jonaboecker/turingmaschine/assets/Treiber_Kalibrieren.jpg

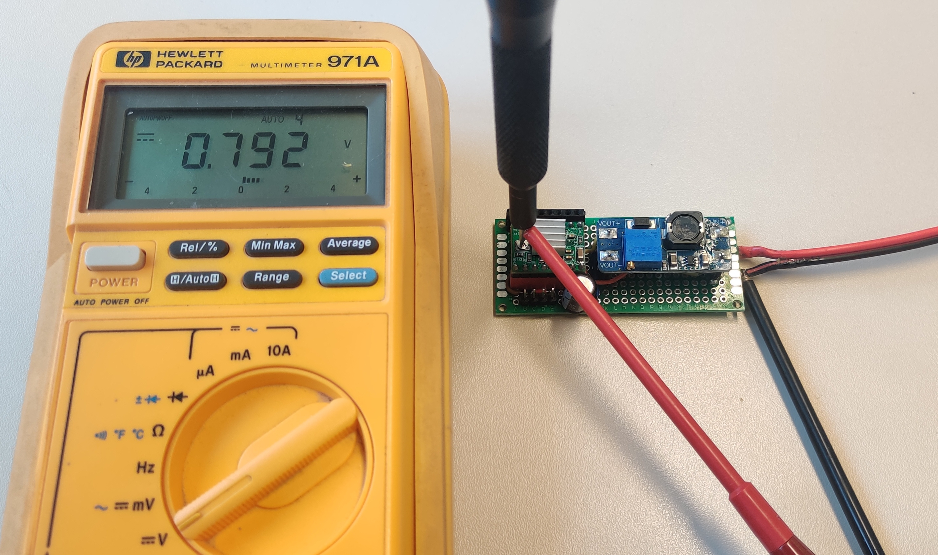
assets/Treiber_Kalibrieren.jpg
