jonaboecker/turingmaschine/assets/TCS3200_Pinout.png

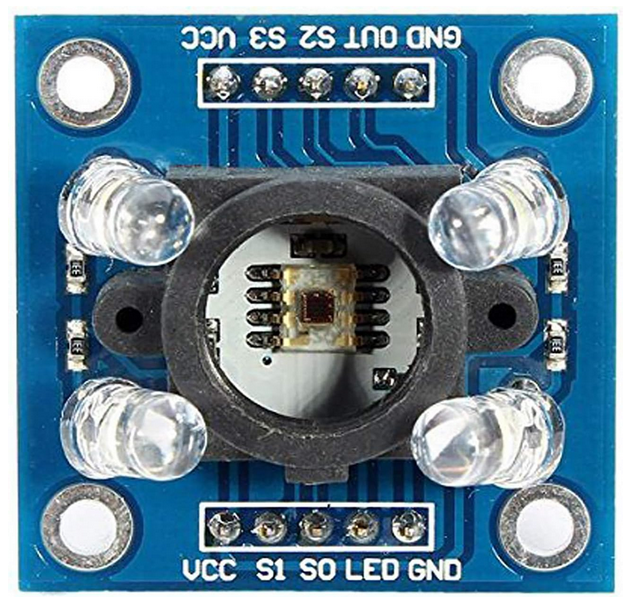
assets/TCS3200_Pinout.png
