jonaboecker/turingmaschine/arduino/assets/images/TM_Taster.jpg

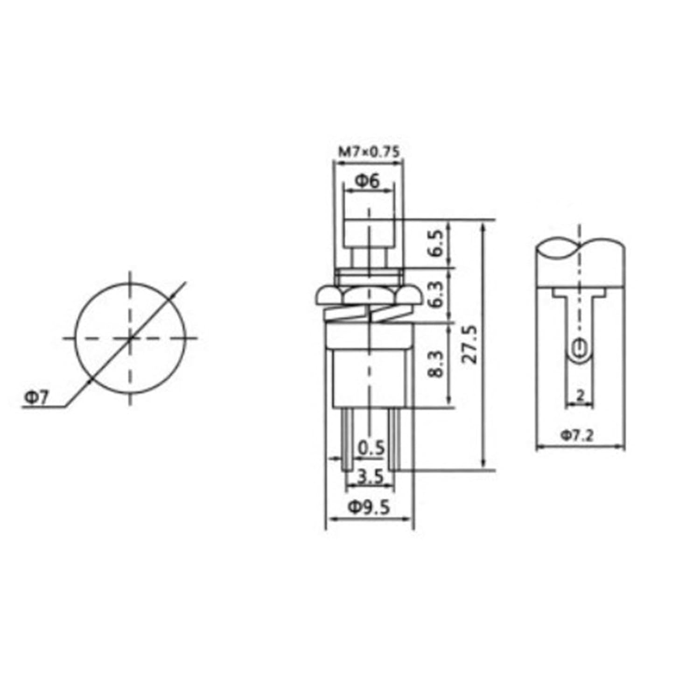
arduino/assets/images/TM_Taster.jpg
