jonaboecker/turingmaschine/arduino/assets/images/turingmachine_io_ribbon_prototype_breadBoard.png

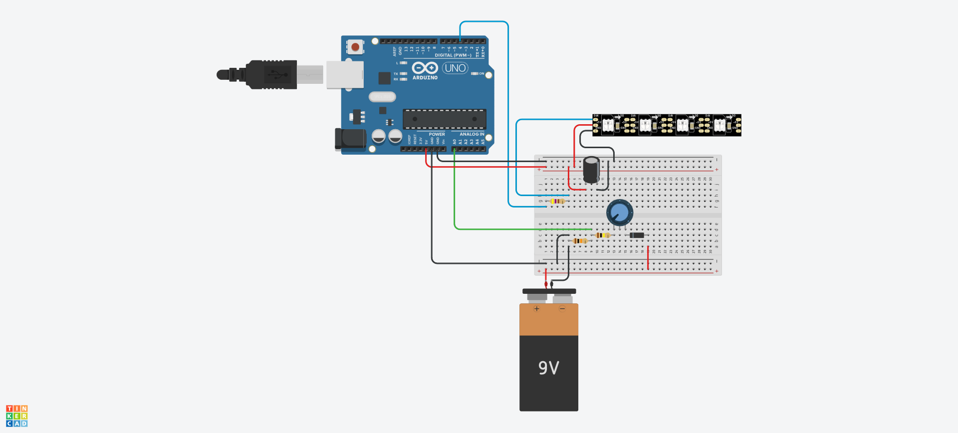
arduino/assets/images/turingmachine_io_ribbon_prototype_breadBoard.png
