jonaboecker/turingmaschine/arduino/assets/images/turingmachine_io_ribbon_prototype_circuitDiagram_pic.png

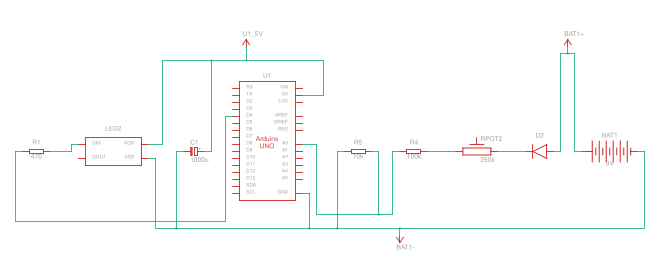
arduino/assets/images/turingmachine_io_ribbon_prototype_circuitDiagram_pic.png
