jonaboecker/turingmaschine/assets/17HE19-2004S_Steppermotor_Datasheet.png

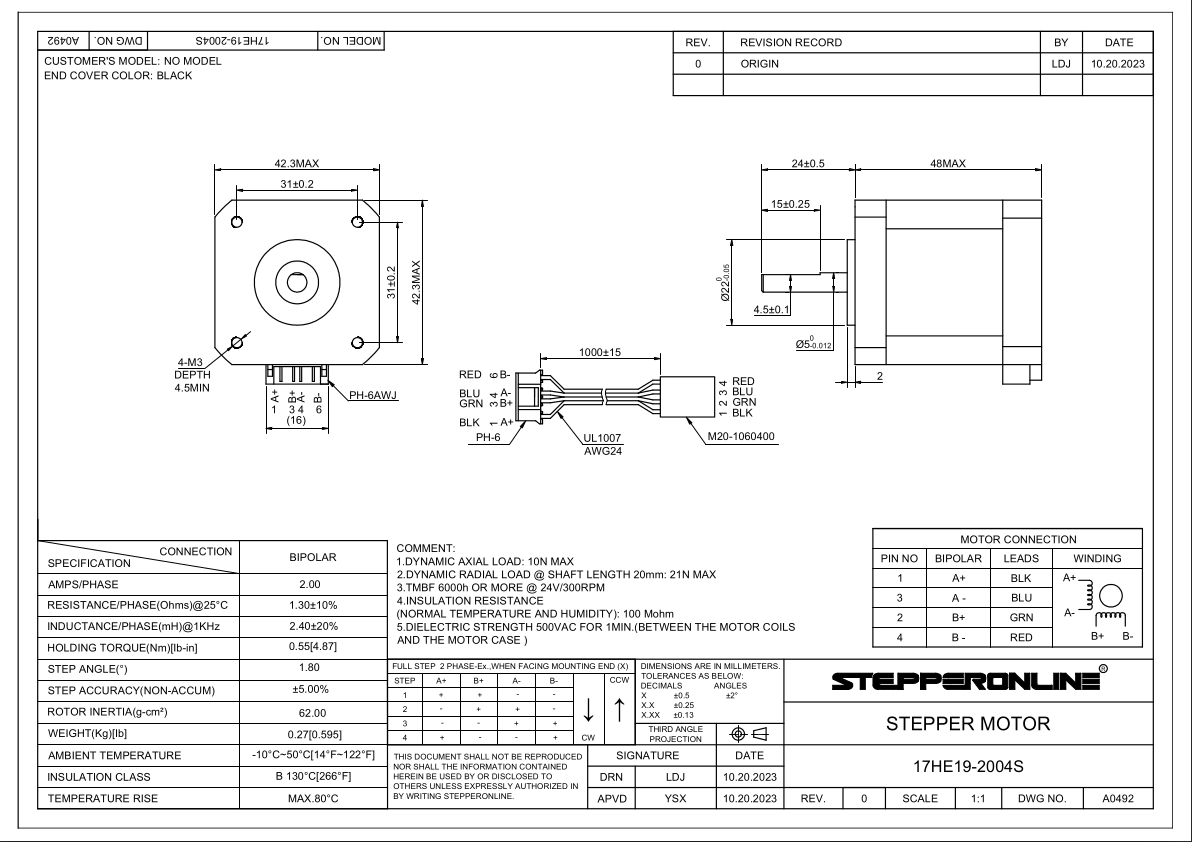
assets/17HE19-2004S_Steppermotor_Datasheet.png
