jonaboecker/turingmaschine/assets/A4988_Driver_Pinout.png

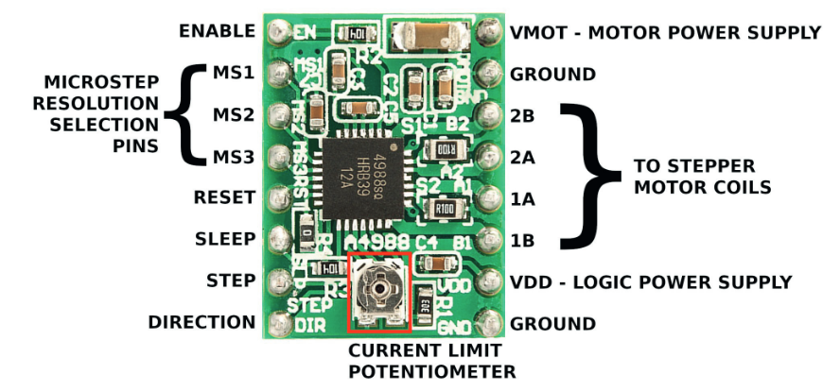
assets/A4988_Driver_Pinout.png
