jonaboecker/turingmaschine/assets/cabel_chain_output_cabel.png

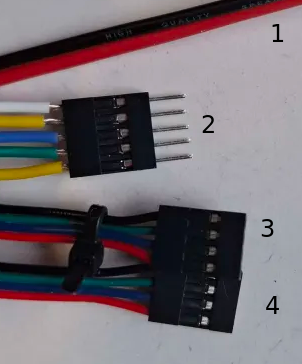
assets/cabel_chain_output_cabel.png
