jonaboecker/turingmaschine/assets/Display_Anschluss.png

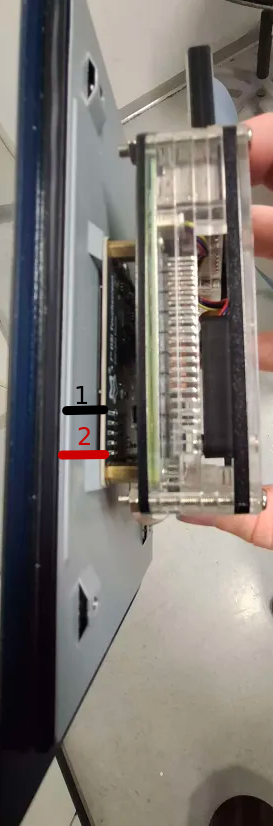
assets/Display_Anschluss.png
