jonaboecker/turingmaschine/assets/Lego_GearRack_w_Border_191mm.PNG

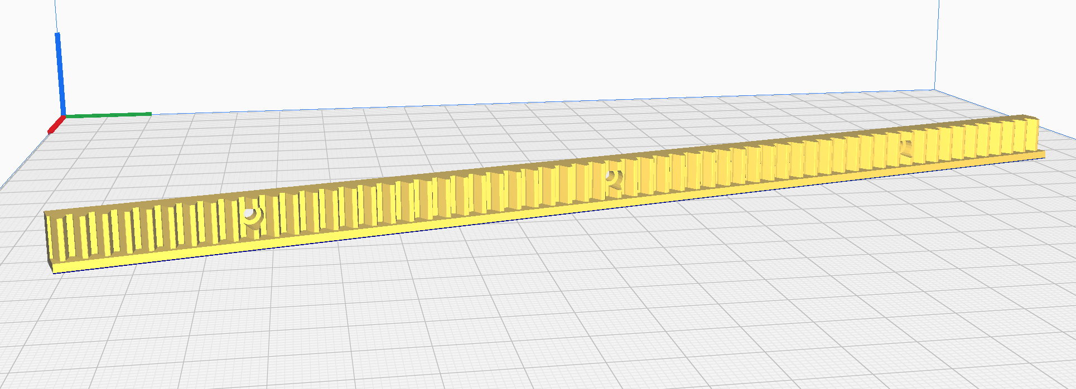
assets/Lego_GearRack_w_Border_191mm.PNG
