jonaboecker/turingmaschine/assets/Lichtschranke.png

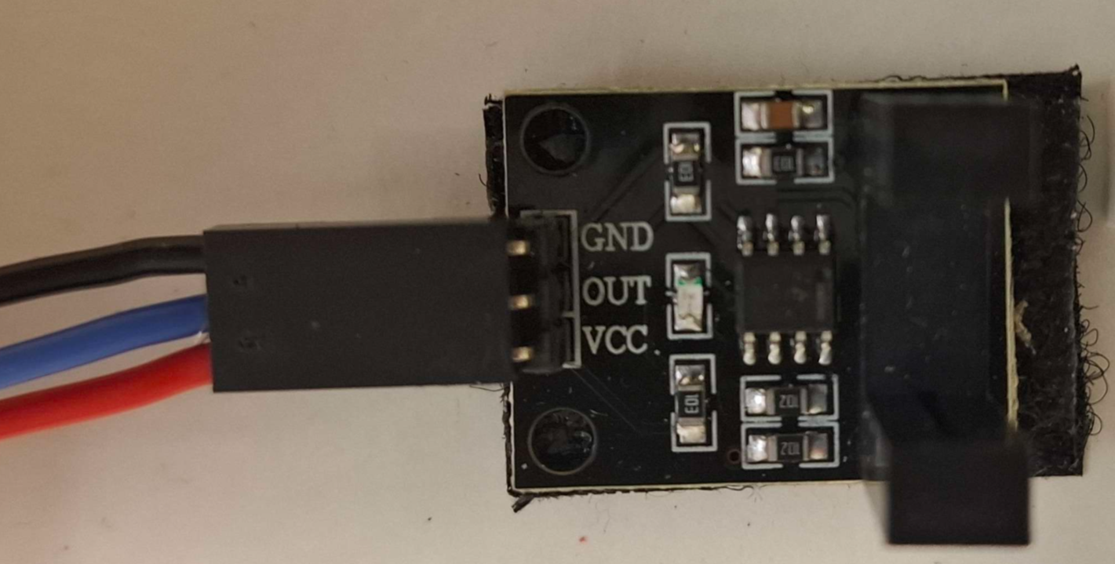
assets/Lichtschranke.png
