jonaboecker/turingmaschine/assets/LM393 Lightsensor.png

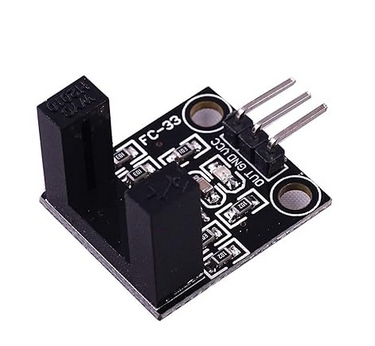
assets/LM393 Lightsensor.png
