jonaboecker/turingmaschine/assets/Netzteil_5V_Ground.png

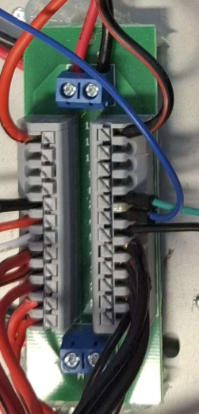
assets/Netzteil_5V_Ground.png
