jonaboecker/turingmaschine/assets/RGB_LED_Voltage_supply_module.jpg

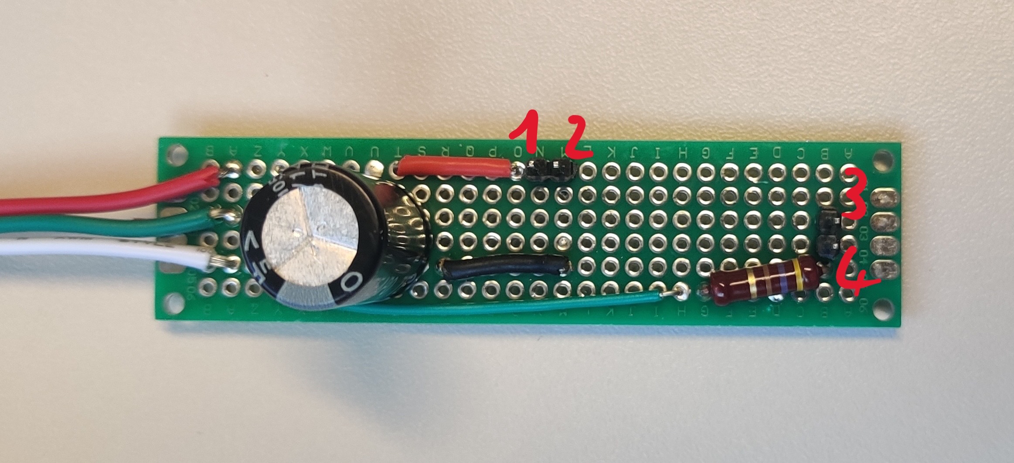
assets/RGB_LED_Voltage_supply_module.jpg
