jonaboecker/turingmaschine/assets/roboter_VGA.png

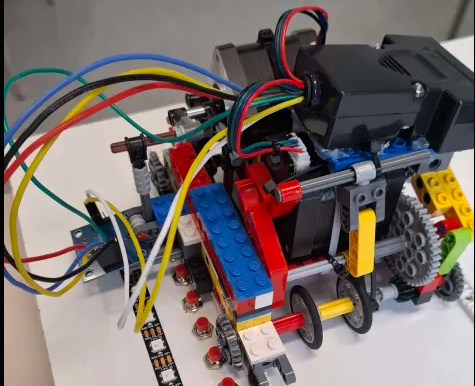
assets/roboter_VGA.png
