jonaboecker/turingmaschine/assets/roboter_VGA_cable_chain.png

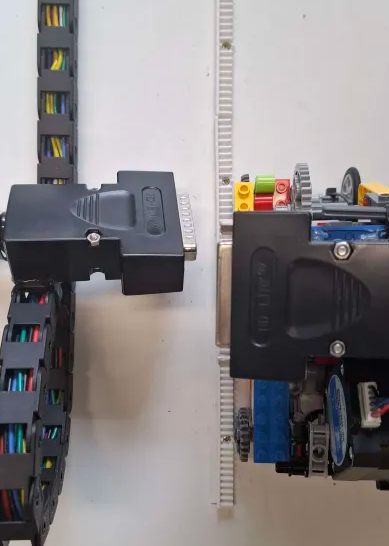
assets/roboter_VGA_cable_chain.png
