jonaboecker/turingmaschine/assets/Schaltplan_Steppermotor_Modul.png

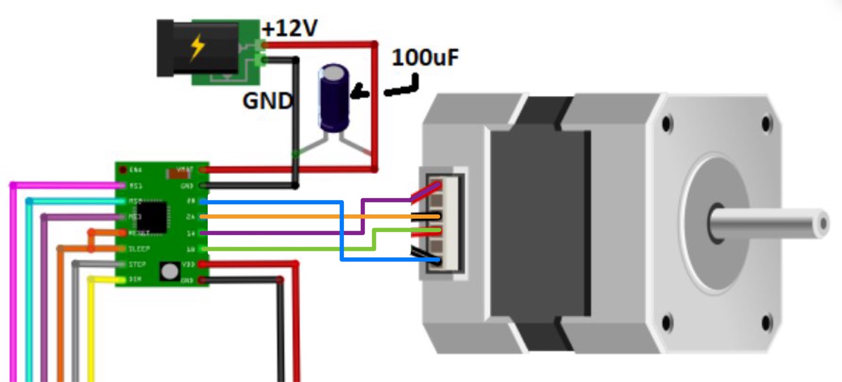
assets/Schaltplan_Steppermotor_Modul.png
