jonaboecker/turingmaschine/assets/Spannungswandler_bedienung.png

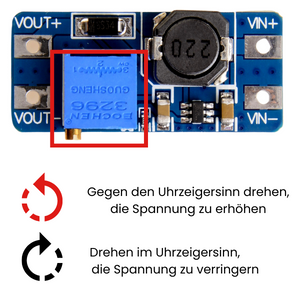
assets/Spannungswandler_bedienung.png
