jonaboecker/turingmaschine/assets/Steppermotor_controlling_and_voltage_supply_module.jpg

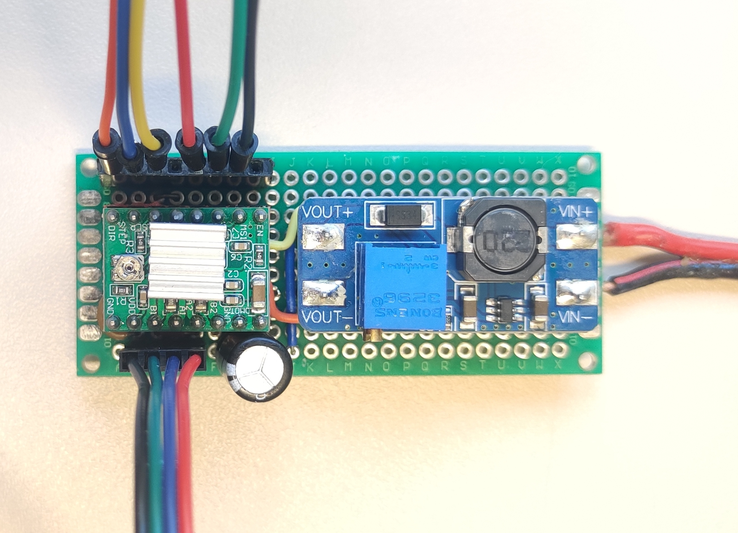
assets/Steppermotor_controlling_and_voltage_supply_module.jpg
