jonaboecker/turingmaschine/assets/Steppermotoren_Anschluss.png

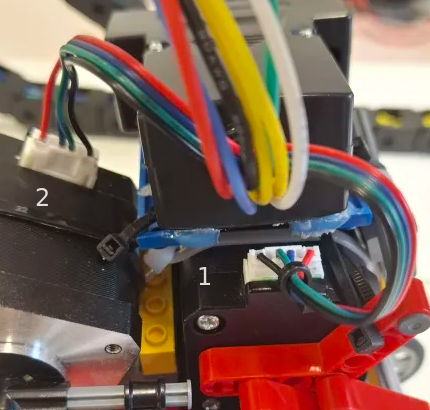
assets/Steppermotoren_Anschluss.png
