jonaboecker/turingmaschine/assets/Stromversorgung_Rasberry_und_Display.png

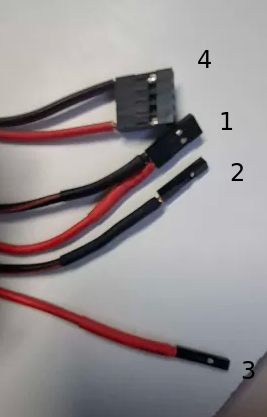
assets/Stromversorgung_Rasberry_und_Display.png
