jonaboecker/turingmaschine/assets/Tastermatrix.png

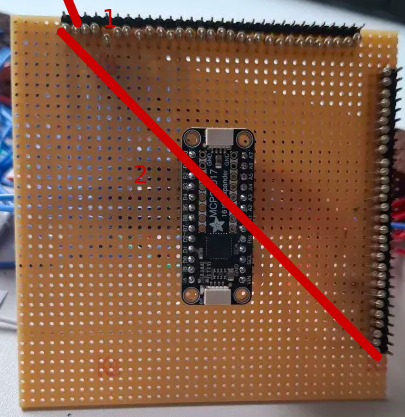
assets/Tastermatrix.png
