jonaboecker/turingmaschine/assets/Tastermatrix_h.png

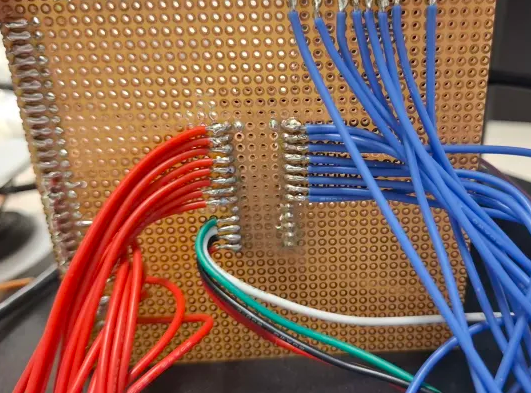
assets/Tastermatrix_h.png
