jonaboecker/turingmaschine/assets/Treiber_Arduino_Kabel_beschriftet.png

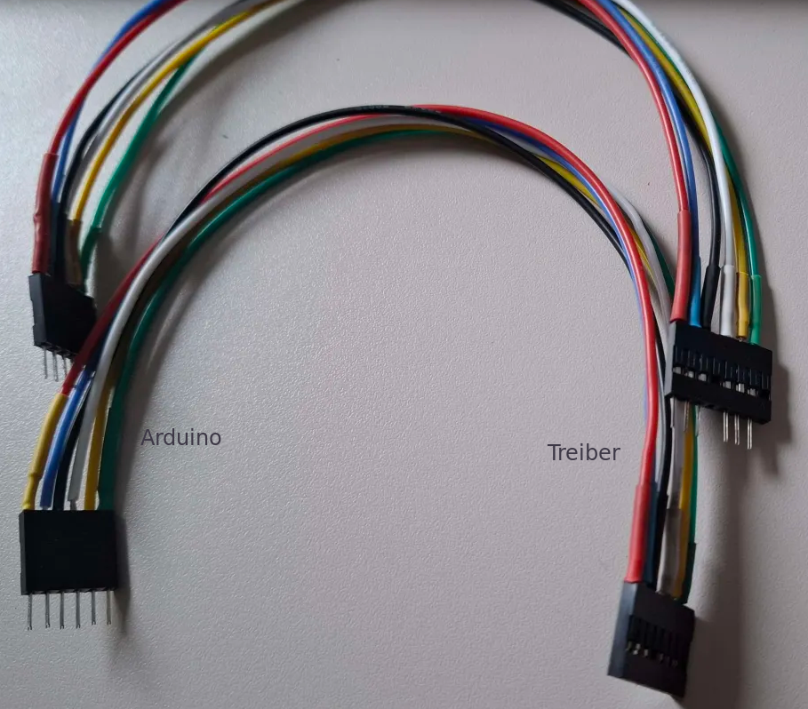
assets/Treiber_Arduino_Kabel_beschriftet.png
