jonaboecker/turingmaschine/assets/Treiber_cabel_chain.png

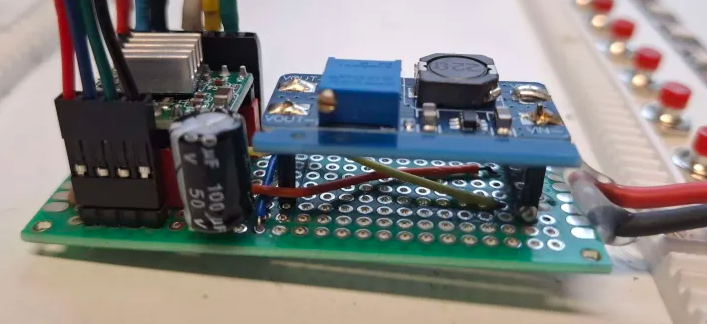
assets/Treiber_cabel_chain.png
