jonaboecker/turingmaschine/assets/Treiber_Kabel.png

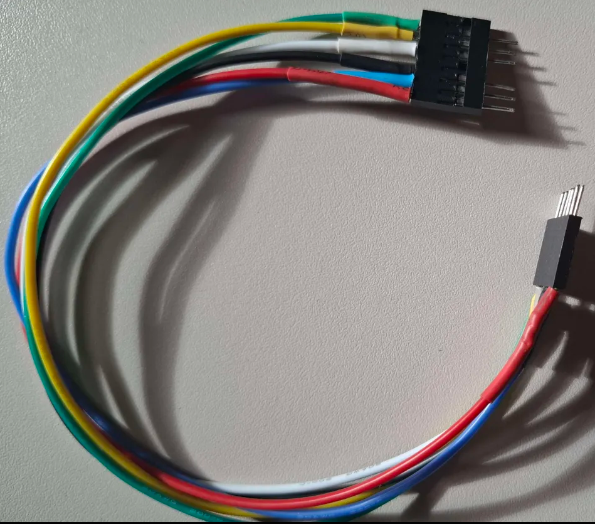
assets/Treiber_Kabel.png
