jonaboecker/turingmaschine/assets/Treiber_Pin.png

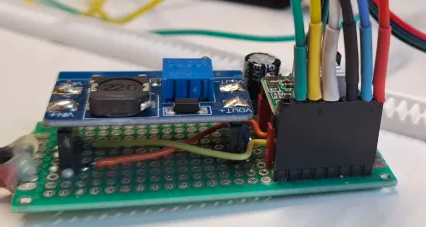
assets/Treiber_Pin.png
