jonaboecker/turingmaschine/assets/UART.png

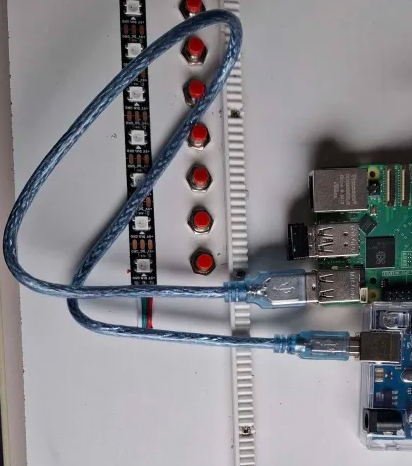
assets/UART.png
