jonaboecker/turingmaschine/assets/VGA_Lichtsensor.png

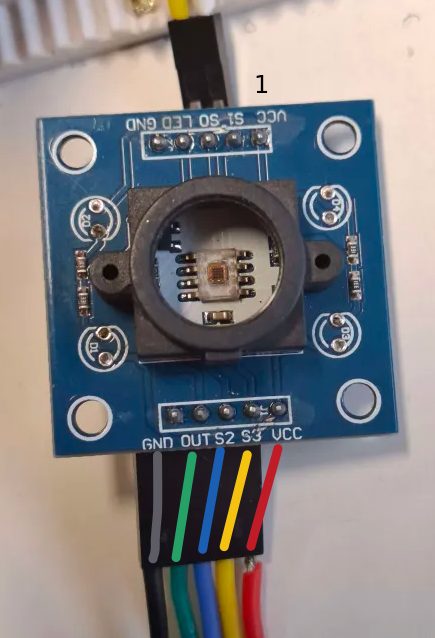
assets/VGA_Lichtsensor.png
