jonaboecker/turingmaschine/raspberry/assets/Display_rotation_config.png

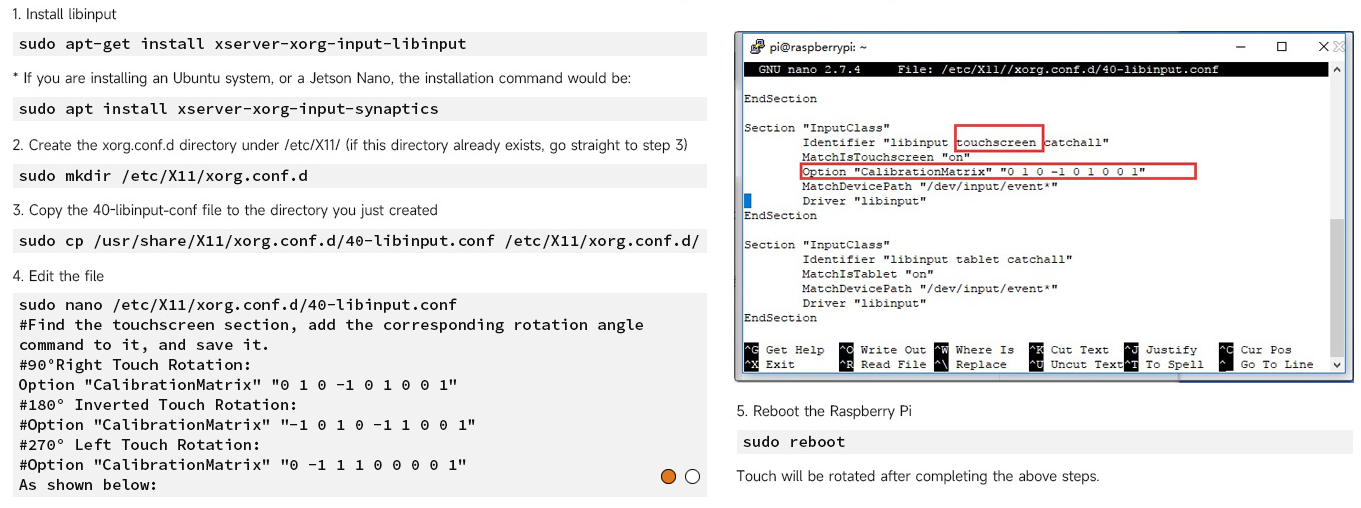
raspberry/assets/Display_rotation_config.png
