jonaboecker/turingmaschine/raspberry/assets/Display_Touch_config.png

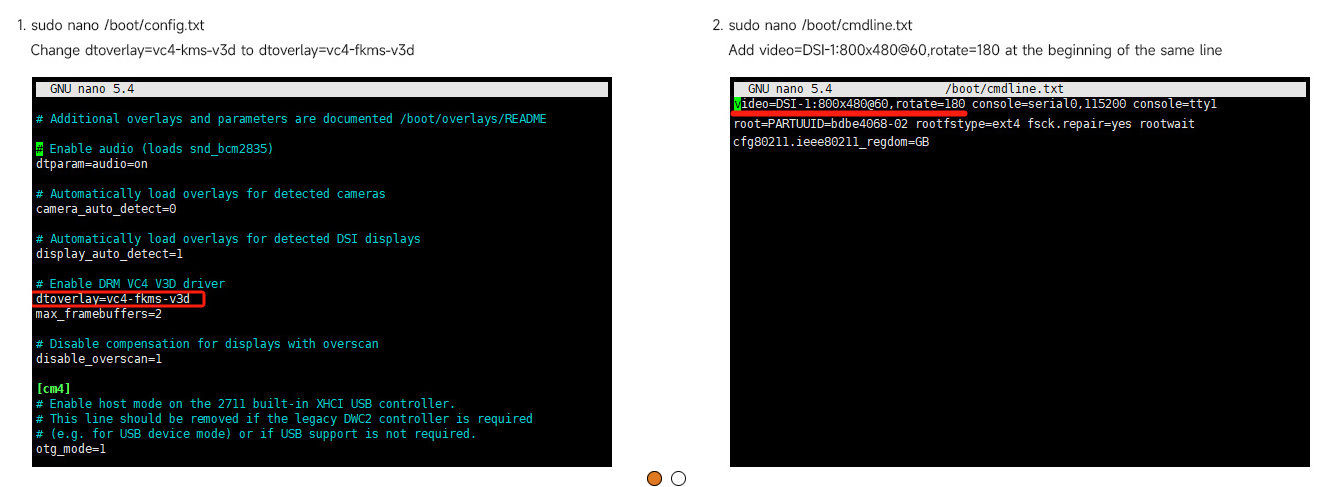
raspberry/assets/Display_Touch_config.png
