jonaboecker/turingmaschine/raspberry/assets/raspberry-pi-gpio.jpg

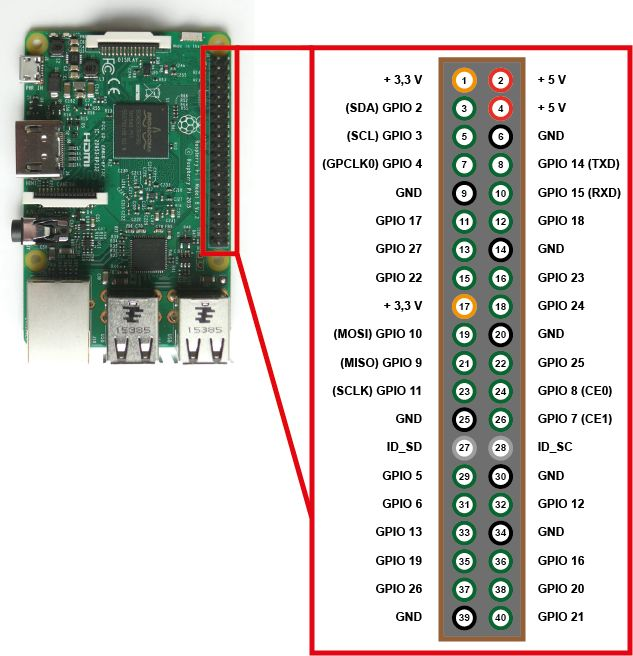
raspberry/assets/raspberry-pi-gpio.jpg
