jonaboecker/turingmaschine/assets/Lego_GearRack_w_Border_191mm.stl

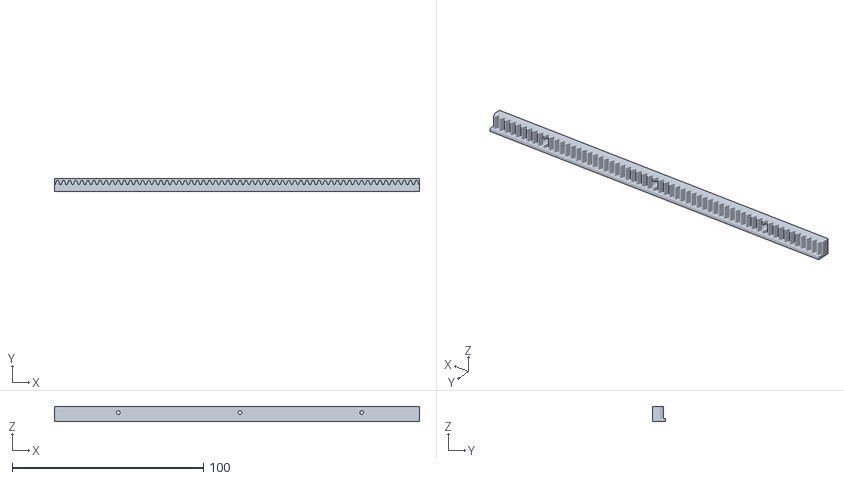
[picture p34: CAD file, 2024-12-25]
assets/Lego_GearRack_w_Border_191mm.stl
191.0 x 7.00 x 7.96
