jonaboecker/turingmaschine/assets/Spannungswandler_Kalibrierung.jpg

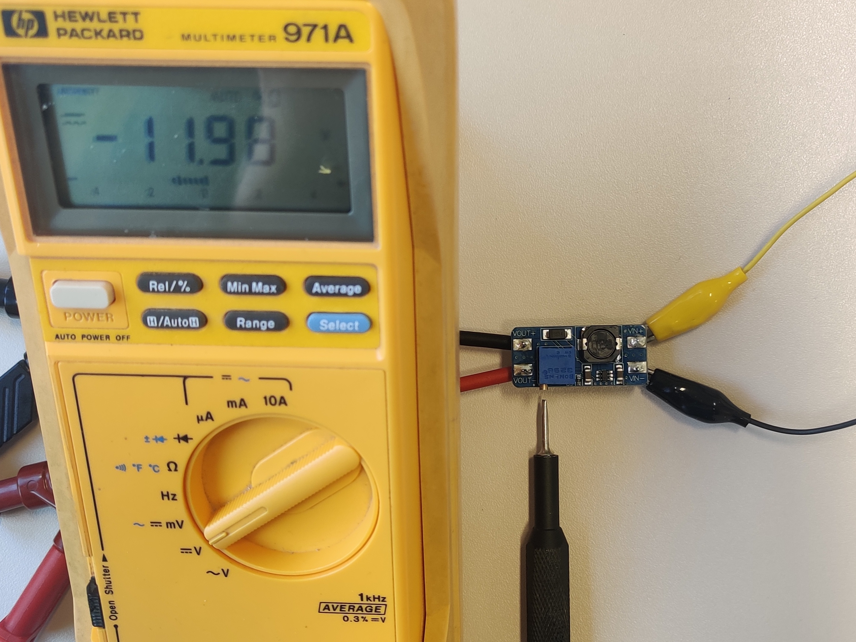
assets/Spannungswandler_Kalibrierung.jpg
