jonaboecker/turingmaschine/(threads)

Thread 1 (2024-11-19):

Set the secret key to some secret random bytes.

jonaboecker, 2024-11-19:
in app.py:
current secret_key
app.secret_key = 'this is a very secure secret key which we will definitely replace later'
should set to some random bytes not included in repo. For example with environmental variable like
# app.secret_key = os.environ.get('Flask_Secret_Key_WISSINGER')

Thread 10 (2024-11-28):

Positonsfindung (Spannungsteiler)

jonaboecker, 2024-11-28:
# Spannungsteiler

## Einbinden des Spannungsteilers
> * [ ]  Einbau des fertigen Konzepts (Weiterentwickelter Prototyp aus Ideensammlung)
> * [ ]  Verkabelung (VCC)

## Prototyping (proof of concept)
> * [x]  Graphitspur mit hohem widerstand
> * [x]  Sensorwerte auslesen und interpretieren

###  Ideensammlung (endgültige Lösung)
> * Nichrome draht mit angelöteten Kupferplättchen für bessere Eingabe
>     * Widerstand auf einen Meter (Berechnet: (1.10\*10^(-6))\*1/((0,3/2\*10^(-3))^2\*\pi) = 15.56Ohm/m
> * Verbinden der Kupferplättchen mit gleichen Widerständen für gleichmäßige Widerstandserhöhung

## Hardware
> * [ ] Nichrome draht
> * [X] Kupferband
> * [X] Widerstände

l0n1y, 2025-01-08:
Bei 60 messpunkten und einem Widerstand von 1000 Ohm zwischen jedem Messpunkt ergibt sich ein Strom von 0,0004A bei 24V.
das heißt alle 0,4V haben wir eine neue LED die angesteuert wird.

24 V / 60000 Ohm = 0,0004 A
0,0004 A * 1000 Ohm = 0,4 V für den ersten Messpunkt
0,0004 A * 2000 Ohm = 0,8 V für den zweiten Messpunkt
usw.

Bei 5V:
5 V / 60000 Ohm = 0.000083 A
0.000083 A * 1000 Ohm = 0,083 V für den ersten Messpunkt
0.000083 A * 2000 Ohm = 0,16 V für den zweiten Messpunkt
usw

Da wir keinen Verbraucher an der Leitung haben und wir dort nur Spannung abgreifen wollen ist es am besten die Strom möglichst gering zu halten, um das Risiko eines Gefährlichen Stromschlages zu verringern und das Netzteil und Leitung zu schonen. Der Widerstand kann auch noch erhöht werden das würde keinen weiteren unterschied machen nur verringern sollten wir ihn nicht.

l0n1y, 2025-01-08:
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

Hier ein vereinfachter Schaltplan für den Spannungsteiler

Julz124, 2025-01-16:
Closed due to better solution found

Closed 2025-01-16.

Thread 11 (2024-11-28):

Raspberry konfigurieren

jonaboecker, 2024-11-28:
# Raspbian Installieren und Konfigurieren
## Installations-Konfiguration
- Hostname setzen
- User und PW erstellen
- Time-Zone und Keyboard korrigieren
- Passwort authentifiziertes SSH aktivieren
- WLAN hinzufügen

### **SD-Karte wird nicht über SD-Karten-Slot erkannt**

#### **Lösungsansätze:**
- ✅ Booten über USB-Stick
- ✅ Raspberry Pi umtauschen
  - War eine falsche Vermutung, der Pi hat funktioniert.
- ❌ PCIe NVMe SSD nicht umgesetzt
  - Stattdessen: **Samsung PRO Endurance microSDHC-Karte**, da sie langlebig ist.
#### **Fehler:**
No-Name-microSD-Karten erfüllen oft nicht die erforderlichen Geschwindigkeits-, Kompatibilitäts- und Qualitätsstandards für den Raspberry Pi, was zu Problemen beim Betrieb führen kann.
#### **Problem behoben:**
- Durch den Einsatz der **Samsung PRO Endurance microSDHC-Karte**.

## Konfigurieren des Touchdisplays

> * [x] Display mit Raspberry über "DSI-Interface" verbinden
> * [X] Stromversorgung des Displays über Raspberry 5V-Pin
> * [X] Konfigurieren des Raspberry-Display-Outputs und Touch-Inputs auf das Touch-Display **
    - */boot/firmware/config.txt*
    ```"dtoverlay=vc4-kms-v3d"```
    ```"dtparam=i2c_arm=on"```
    ```"dtoverlay=ft5x06"```
    ```"dtoverlay=vc4-kms-v3d"```
    ```"dtoverlay=touchscreen"```
    - */boot/firmware/cmdline.txt*
    ```"video=DSI-1:800x480@60,rotate=180"```
> * [ ] Stromversorgung mit 5V 5A (für sichere Stromversorgung des PI's und dessen peripherals)

### Touch Display Input Konfigurieren

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

### Touch Display Drehung

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

### Debugging Touchscreen Events

**Touchscreen reagiert nicht!**

#### Diagnose:
1. ```sudo evtest``` zum Prüfen aller einkommenden Events, inklusive der Touch-Events
2. Auflisten aller registrierten Events ```ls /dev/input```
3. Raspbian updaten ***
4. installieren von "xinput-calibrator" zum Kalibrieren des Touchscreens
5. Prüfen ob I²C-Bus aktiviert ist, zur Kommunikation mit Touch-Controller ```ft5x06``` des Displays

** Setzt ssh-Verbindung voraus

SSH Verbindungen
> * [ ] Heimnetzwerk über WLAN
> * [ ] Heimnetzwerk über LAN
> * [X] Direct Ethernet

*Konfiguration des Raspberry Pi 5*
1. ```sudo nmcli con add type ethernet ifname eth0 con-name static-eth0 ipv4.addresses 192.168.2.2/24 ipv4.method manual```
2. ```sudo nmcli con up static-eth0```
3. ```Interface Options``` > ```SSH``` > ```Enable```

*Konfiguration des Hostsystems*
1. ```ip link``` (Auflisten aller Netzwerkinterfaces)
2. ```sudo nmcli con add type ethernet ifname enp2s0 con-name eth-direct-rpi ipv4.addresses 192.168.2.1/24 ipv4.method manual```
4. ```sudo nmcli con up eth-direct-rpi```

*Testen der Ethernet-Verbindung zum Raspberry Pi*
```ping 192.168.2.2```

*Herstellen der SSH-Verbindung*
```ssh turing@192.168.2.2```

*** Setzt Internetverbindung voraus

Internet Verbindungen
> * [x] WLAN
> * [ ] LAN
> * [X] Internet Sharing over Direct Ethernet

*Konfiguration des Hostsystems*
1. Enable permanent IP-Forwarding
```echo "net.ipv4.ip_forward=1" | sudo tee -a /etc/sysctl.conf```
```sudo sysctl -p```
2. Configure NAT
    - providing internet interface ```wlp3s0```
    - forwarding internet interface ```enp2s0```
```sudo iptables -t nat -A POSTROUTING -o wlp3s0 -j MASQUERADE```
```sudo iptables -A FORWARD -i enp2s0 -j ACCEPT```
```sudo iptables -A FORWARD -o wlp3s0 -m state --state RELATED,ESTABLISHED -j ACCEPT```
```sudo apt install iptables-persistent```
```sudo netfilter-persistent save```
```sudo netfilter-persistent reload```

*Konfiguration des Raspberry Pi 5*
1. Auflisten aller verfügbaren Verbindungen
```nmcli con```
2. Setzen neuer Flags auf bestehender Verbindung (Nutzen der hergestellten Verbindung von SSH-Konfigurtion)
```sudo nmcli con modify static-eth0 ipv4.addresses 192.168.2.2/24 ipv4.gateway 192.168.2.1 ipv4.dns 8.8.8.8 ipv4.method manual```
```sudo nmcli con up static-eth0```

*Testen der Verbindung*
- zum Hostsystem: ```ping -c 4 192.168.2.1```
- zum Internet: ```ping -c 4 google.com```

##### Herstellen einer Internetverbindung

# Sensorik und Motor-Treiber

- #4
- #5
- #6

## Anschluss/Ansteuerung
### Konfiguration

# Turing-Maschine (Visuelle Oberfläche)
## Konfiguration
> * [x] Programm in Autostart setzen (Dockercontainer)
> * [x] Automatische Initialisierung
> * [x] Automatische erkennung weiterer Datenträger zum einspielen von weiteren Programmen für TM

#Schritte zur Autostart-Einrichtung
- Docker-Image aus den Artifacts herunterladen.
- Speichere das Skript als startup.sh auf deinem Raspberry Pi.
- Mache es ausführbar mit: "chmod +x startup.sh"
- Erstelle einen systemd-Service, um das Skript nach jedem Boot automatisch auszuführen:
   * .service Datei unter /etc/systemd/system/docker-autostart.service auf dem Raspberry Pi ablegen
   * dann "sudo systemctl daemon-reload"
   * und "sudo systemctl enable docker-autostart.service"

# Potenzielle Fehler
- ### Raspberry Pi startet nicht
    - Falls der Bildschirm Schwarz ist und über einen USB-Stick gebootet wird, einmal kurz auf den An/Aus Button drücken
        - Der Fehler entsteht dadurch, dass der Raspberry Pi, falls dieser zu wenig Strom erhält (Normal sind 5V auf 5A) nicht über normalem Weg über einen USB-Stick booten kann.
    - Falls der Bildschirm schwarz ist und über den SD-Karten-Slot gebootet wird, die SD-Karte in einen USB-Stick stecken und darüber booten

TobiasReyEye, 2025-01-29:
Die Autostart-Scripte für den RaspberryPi liegen im Git-Repository.
Schritte zur Einrichtung im Issue ergänzt.

Closed 2025-03-13.

Thread 13 (2024-11-28):

Konzeptausarbeitung Programmierinterface (Turingmaschinenprogramm)

jonaboecker, 2024-11-28:
Hallo Herr Böcker,

wie besprochen wäre das hier die Syntax die Ihr System auf jeden Fall unterstützen soll, bei Bedarf gebe ich Ihnen auch nochmal Zugriff auf meinen Moodle-Kurs, da gibt es ein paar Beispieldateien

https://turingmachinesimulator.com/

Das ist die Syntax die Ihr Tool auf jeden Fall können muss.

Dann aber so als Herausforderung, etwas schicker aussehend:
https://turingmachine.io/

Mit verfügbarem Code:
https://github.com/aepsilon/turing-machine-viz

Syntax der Sprache sieht etwas komplexer, dafür Python-artiger aus.

Vielleicht schaffen Sie auch die Umsetzung. Und vielleicht hilft Ihnen der Code auch beim Interpretieren / Simulieren.

Viele Grüße, gute Besserung und bis nächste Woche
Barbara Staehle

Closed 2024-12-05.

Thread 14 (2024-11-28):

Import + Parser Programmierinterface

jonaboecker, 2024-11-28:
- [x] Fileupload und speichern ermöglichen
- [x] Parsen der sprache von https://turingmachinesimulator.com/
- [x] Parsen der Sprache von https://turingmachine.io/ (Optional)
- [x] Umschreiben des Codes in Datenstruktur
- [x] F. Staehle entscheiden lassen, ob Endzustände definiert werden müssen

jonaboecker, 2024-12-02:
Parser für erste Sprache (https://turingmachinesimulator.com/) implementiert
bea542d4

jonaboecker, 2024-12-10:
Parser  https://turingmachine.io/ implementiert, fehlende Endzustände werden als Warning ausgegeben und als nicht akzeptierende Endzustände interpretiert. 362911da

Closed 2025-01-23.

Thread 16 (2024-11-28):

Programmablauf entwickeln

jonaboecker, 2024-11-28:

jonaboecker, 2024-12-10:
State-Maschine Controller implementiert (nicht testbar, da Hardwareansteuerung noch nicht implementiert) 3e330e8

jonaboecker, 2025-01-23:
- State-Machine läuft in eigenem Thread um den restlichen Server lauffähig zu halten
- Server erhält weiterhin Threadsicheren Zugriff auf die Klasse der State-Machine um  Updates live anzuzeigen
- sobald ein Nutzer auf die /running_program Seite wechselt wird eine Websocket-verbindung aufgebaut und bei Änderungen der State geupdatet
- Pause/ Stopflags können über Buttons gesetzt werden, die State-Maschine hält dann an passenden Punkten an (Kann bspw. nicht bei laufenden Bewegungen gestoppt werden)

Thread 3 (2024-11-28):

Zahnradschiene 3D drucken

jonaboecker, 2024-11-28:
### 3D-Druck an der HTWG
- [ ] OIL-Lehrgang

#### Alternativ
- [ ] FabLab Universität Konstanz
- [X] Privat Drucken

### Prototyping mit Existierenden 3D-Modellen
- 24 Lego Rack Gear
[https://www.thingiverse.com/thing:1451177](url)
- Lego Rack Gear 8
[https://www.thingiverse.com/thing:3779182](url)

#### Weitere Bearbeitung
- [X] Hinzufügen von Leitschiene und Montagelöcher in Tinkercad und Testdruck mit privatem Drucker
    - Erfolgreicher Testdruck einer Probeschine
    - weiterer Druck von Finaler Zahnradschiene (siehe unten)
    ##### 3D-Datei
        https://github.com/jonaboecker/turingmaschine/blob/main/assets/Lego_GearRack_w_Border_191mm.stl

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

Closed 2024-12-25.

Thread 6 (2024-11-28):

Ansteuerung Lichtschranke

jonaboecker, 2024-11-28:
# Lichtsensor (Lichtschranke)

## Hardware
- [x] Anschließen des Sensors an die Endkonfiguration:
  - [x] GPIO-Pin für den Lichtsensor als Eingang definieren.

## Lichtschranke-Logik
- [x] Erfassen des Zustands (blockiert oder nicht blockiert):
  - Der Sensor gibt ein digitales Signal aus (z. B. `1` für nicht blockiert und `0` für blockiert).
- [x] Implementieren einer Funktion `get_state`

```python
import RPi.GPIO as GPIO

SENSOR_PIN = 17

# GPIO-Pin als Eingang setzen
GPIO.setmode(GPIO.BCM)
GPIO.setup(SENSOR_PIN, GPIO.IN)

def get_state():
    """
    Get the state of the light barrier.

    Returns:
        bool: The state of the light barrier (True if blocked, False if not blocked).
    """
    return GPIO.input(SENSOR_PIN) == 1
```

## Dokumentation
> [] Dokumentieren, wie der Sensor angeschlossen und konfiguriert wird:
    - Pin-Konfiguration: GPIO 17 (SENSOR_PIN) als Eingang gesetzt.
    - Abfrage: GPIO.input(SENSOR_PIN) liest den Zustand des Sensors.
    - Ergebnis: 1 = Lichtschranke blockiert, 0 = Lichtschranke frei.

lara00, 2025-03-11:
Probleme mit den GPIO-Pins beim Raspberry Pi 5. Verschiedene Bibliotheken ausprobiert, funktionieren jedoch nicht auf dem OS des Docker-Containers. Daher wurde die Steuerung auf einen Arduino mit serieller Schnittstelle zum Pi verlegt

Closed 2025-03-11.

Thread 8 (2024-11-28):

Roboter designen/bauen

jonaboecker, 2024-11-28:
## Funktionen und Features

> * [X] Zahnradachse
> * [X] Motorhalterungen
> * [X] Motorwelle auf Zahnrad Adapter
     - Lego-Zahnradnabe größer gebohrt und auf Motorwelle gesteckt
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

jonaboecker, 2025-03-13:
von @lara00 und @Julz124 erledigt

Closed 2025-03-13.

Thread 17 (2024-12-02):

Parser Testen

jonaboecker, 2024-12-02:
- [x] Fehlerbehandlung des Parsers für https://turingmachinesimulator.com/ testen
- [x] Fehlerbehandlung des Parsers für https://turingmachine.io/ testen

In Modul turingmachine_interpreter

jonaboecker, 2025-01-23:
Beide Parser sind lauffähig

Closed 2025-01-23.

Thread 19 (2024-12-11):

PIN Belegung Raspberry

lara00, 2024-12-11:
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
Quelle: [Elektronik Kompendium - Lichtschranke am Raspberry Pi](https://www.elektronik-kompendium.de/sites/raspberry-pi/1907101.htm)

## Pin-Verbindung: TCS230/TCS3200 zu Raspberry Pi

| **TCS3200 Pin** | **Raspberry Pi Pin** | **Beschreibung**                                      |
|-------------------------|----------------------|------------------------------------------------------|
| **VCC**                | Pin 2 (5V)          | Stromversorgung (+5V)                                |
| **GND**                | Pin 6 (GND)         | Masse (Ground)                                       |
| **S0**                 | Pin  16 (GPIO23)     | Steuerung für Frequenz-Skalierung                    |
| **S1**                 | Pin 18 (GPIO24)     | Steuerung für Frequenz-Skalierung                    |
| **S2**                 | Pin 13 (GPIO27)     | Auswahl der Fotodioden (Rot, Grün, Blau)             |
| **S3**                 | Pin 15 (GPIO22)     | Auswahl der Fotodioden (Rot, Grün, Blau)             |
| **OUT**                | Pin 11 (GPIO17)     | PWM-Ausgang (Frequenzsignal für Farbmessung)         |

lara00, 2024-12-11:
## Pin-Verbindung: LM393-Lichtsensor zu Raspberry Pi

| **LM393 Pin** | **Raspberry Pi Pin** | **Beschreibung**                                          |
|---------------|----------------------|----------------------------------------------------------|
| **VCC**       | Pin ? (5V)          | Stromversorgung (+5V)                                     |
| **GND**       | Pin ? (GND)         | Masse (Ground)                                            |
| **OUT**       | Pin ? (GPIO17)     | Digitaler Ausgang (HIGH/LOW, abhängig von der Lichtintensität) |

lara00, 2025-01-10:
### Pin-Verbindung: A4988 Schrittmotor-Treiber zu Raspberry Pi

| **A4988 Pin** | **Raspberry Pi Pin (GPIO)** | **Beschreibung**                                                |
|---------------|-----------------------------|------------------------------------------------------------------|
| **VDD**       | Pin 1 (3,3V)               | Stromversorgung für die Logik des Treibers (+3,3V)              |
| **GND**       | Pin 39 (GND)               | Masse (Ground)                                                  |
| **VMOT**      | Externe Stromquelle        | Motorstromversorgung (z. B. 12V oder 24V, abhängig vom Motor)   |
| **GND (VMOT)**| Externe Masse              | Masse für die Motorstromversorgung                              |
| **STEP**      | Pin 35 (GPIO 19)           | STEP-Pin für Schrittsteuerung des Motors                        |
| **DIR**       | Pin 20 (GPIO 20)           | DIR-Pin für die Drehrichtung des Motors                         |
| **ENABLE**    | Pin 37 (GPIO 26)           | ENABLE-Pin zum Aktivieren/Deaktivieren des Treibers (optional)  |

lara00, 2025-03-11:
Die Sensorik wurde auf einen Arduino Uno verlegt. Nur noch Bildschirm und Stromversorgung über PI

Closed 2025-03-11.

Thread 24 (2025-01-23):

Parser für lokales Testen beim Enduser exportieren

jonaboecker, 2025-01-23:
User muss Programm herunterladen können, File und Sprache auswählen und bekommt anschließend eine anzeige der Möglichen Probleme im Programmcode.

jonaboecker, 2025-03-13:
Aktueller Workaround: Dockercontainer lokal ausführen oder Projekt clonen und laut README im Raspberry Flask Anwendung starten.
