jonaboecker/turingmaschine/arduino/assets/turingmachine_io_ribbon_prototype_circuitDiagram.pdf

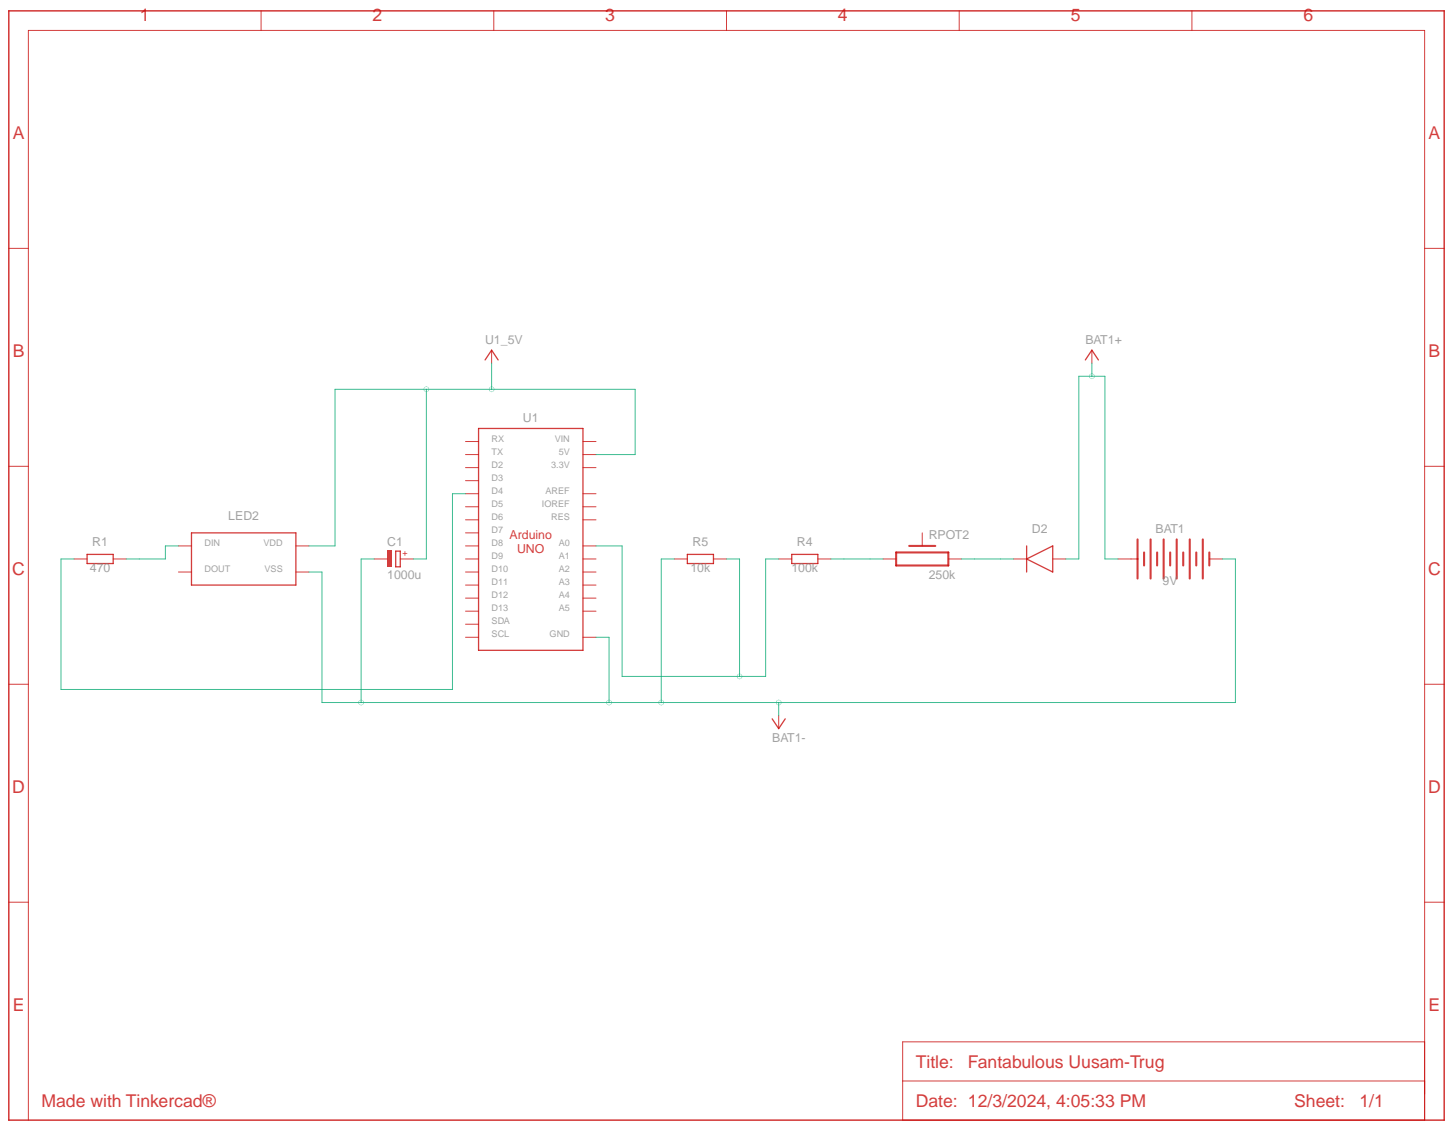
[picture p36: page 1]

Title: Fantabulous Uusam-Trug
