jonaboecker/turingmaschine/raspberry/hardware_control.py

"""
This module contains Stepper Motor and Light Barrier Control via Serial (UART) with Arduino.
"""
import time
import platform
from random import randrange

import assets

if platform.system() == "Linux":
    import serial

SPEED_DELAY_MAP = {
    1: 50,
    2: 45,
    3: 40,
    4: 35,
    5: 30,
    6: 25,
    7: 20,
    8: 15,
    9: 10,
    10: 7
}

class StepperMotorController:
    """
    Controls the stepper motors via a serial connection.
    Supported Commands:
      - TOGGLE
      - SETUP
      - CLEANUP
      - MOVE <direction> <speed> <steps>
    """

    def __init__(self,
                 app,
                 serial_port=assets.SERIAL_PORT,
                 baudrate=assets.BAUDRATE,
                 timeout=assets.TIMEOUT):
        # Flask app for config. Config changes are just supported after StateMachine restart.
        self.app = app
        self.current_position = 1
        if platform.system() == "Linux":
            try:
                self.ser = serial.Serial(serial_port, baudrate, timeout=timeout)
                time.sleep(2)
                self.ser.reset_input_buffer()
            except Exception as e:
                print(f"Error opening serial port: {e}")
                raise e

    def wait_for_ack(self, timeout=assets.TIMEOUT):
        """
        Waits for a serial response from the Arduino.
        Accepts only messages that start with "ACK:".
        """
        start_time = time.time()
        while time.time() - start_time < timeout:
            if self.ser.in_waiting:
                line = self.ser.readline().decode('utf-8').strip()
                if line.startswith("ACK:"):
                    ack_val = line.split("ACK:")[1]
                    return ack_val
            time.sleep(0.01)
        print("Timeout beim Warten auf ACK.")
        return 0


    def send_command(self, command: str) -> int:
        """
        Sends a command to the Arduino and waits for confirmation.
        Returns 1 if the confirmation ("1") is received, otherwise 0.
        """
        try:
            full_command = (command + "\n").encode('utf-8')
            self.ser.write(full_command)
            return int(self.wait_for_ack())
        except serial.SerialTimeoutException:
            print("Timeout error: Command could not be sent in time.")
            return 0
        except serial.SerialException as e:
            print(f"Serial error: {e}")
            return 0

    def toggle_io_band(self):
        """Toggles the IO band state."""
        if platform.system() == "Linux":
            return self.send_command("TOGGLE")
        return False

    def setup_pins(self):
        """Cleans up the Aduino pins."""
        return self.send_command("SETUP")

    def cleanup(self):
        """Cleans up the Aduino pins."""
        return self.send_command("CLEANUP")

    def move_robot_led_step(self, direction: assets.ROBOT_DIRECTIONS, speed=1, steps=1) -> int:
        """
        Moves the robot by one LED step in the specified direction.
        :return:    -2 if the robot would move out of the LED strip,
                    -1 if there was an error while moving the robot
                    else current LED position.

        Args:
            direction (Enum): The direction in which the robot should move
            Enum('Direction', [('LEFT', 1), ('RIGHT', 2)]).
            speed (int): The speed of the robot.
            steps (int): The amount of LEDs the robot should move.
        """
        # Count the new position
        if direction is assets.ROBOT_DIRECTIONS.LEFT:
            self.current_position -= steps
        elif direction is assets.ROBOT_DIRECTIONS.RIGHT:
            self.current_position += steps
        # Check if the new position is inside band
        if self.current_position < 1 or self.current_position > self.app.config['LED_AMOUNT']:
            return -2
        if not self.move_robot(direction, speed, self.app.config['STEPS_BETWEEN_LEDS'] * steps):
            print(
                f"Error: Robot failed to move while \"Move robot: direction: {direction} "
                f"delay_in_ms: {speed} steps: {steps}\".")
            return -1
        return self.current_position

    def move_robot(self, direction: assets.ROBOT_DIRECTIONS, speed: int = 5,
                   steps: int = 1) -> bool:
        """
        Moves the robot in the specified direction by the specified amount of steps.
        :return: False if the robot would move out of the LED strip. Else True
        
        Args:
            direction (str): "LEFT" or "RIGHT" to set rotation direction.
            speed (int): int from 1 to 10 representing the robot-speed, 1 is slow 10 is fast.
            steps (int): The amount of steps the robot should move.
        """
        if direction is assets.ROBOT_DIRECTIONS.HOLD:
            return True
        delay_in_ms = SPEED_DELAY_MAP.get(speed, 10)
        print(f"Move robot: direction: {direction} delay: {delay_in_ms} sm-steps: {steps}")
        if platform.system() == "Linux":
            drict = "LEFT" if direction is assets.ROBOT_DIRECTIONS.LEFT else "RIGHT"
            command = f"MOVE {drict} {delay_in_ms} {steps}"
            return self.send_command(command) != 0
        time.sleep(delay_in_ms / 10)
        return True

    def get_lb_state(self) -> bool:
        """
        Get the state of the light barrier.

        Returns:
            bool: state The of the light barrier (True if blocked, False if not blocked).
        """
        if platform.system() == "Linux":
            state = self.send_command("LIGHT") == 1
            print(f"Light barrier: get_lb_state will return {state}.")
            return state
        state = randrange(2) == 1
        print(f"Light barrier: (Simulated) Returned {state}.")
        return state  # simulated value for non-Raspberry-Pi-Systems

    def get_color(self):
        """
        Retrieves the detected color from the color sensor.

        Returns:
            IO_BAND_COLORS: The detected color as an Enum ('RED', 'BLUE', or 'BLANK'),
                            or None in case of an error.
        """
        if platform.system() != "Linux":
            random_color = assets.IO_BAND_COLORS(randrange(3))
            return random_color
        color = assets.IO_BAND_COLORS(int(self.send_command("COLOR")))
        print(f"get color: {color}")
        return color
