jonaboecker/turingmaschine/(commit log)

2024-12-02 Prototyping with graphite resistor
2024-12-03 Update color sensor concept
2024-12-03 Add images of IO prototype
2024-12-04 fixed design issuses, added delete functionality, added run/programm page without functionality
    [app.py]
2024-12-10 Test color sensor on Raspberry Pi
2024-12-11 Add light barrier sensor logic in light_barrier.py
2024-12-13 add raspberry pi gpio-asset
2024-12-25 3D Zahnradschiene mit Führung und Schraubenlöcher
    [Lego_GearRack_w_Border_191mm.stl]
2025-01-08 fixed parsing errors with Colour enum and implemented running programm page design
    [app.py, assets.py, turingmachine_interpreter.py]
2025-01-13 Add stepper motor movement functionality
2025-01-15 implemented threading for start program and added currently not working websocket
    [app.py, dannweisstobiesnicht.py]
2025-01-16 added assets and steppermotor/driver code
2025-01-19 Add files via upload
    Ansteuerung der IO-extender über I2C
2025-01-22 fixed currently not working websocket
    [app.py]
2025-01-22 implemented websocket correctly, UI updated to display websocket-state
    [app.py, dannweisstobiesnicht.py]
2025-01-22 fixed minor pylint errors
    [app.py, dannweisstobiesnicht.py]
2025-01-23 added Download possibility for programs, fixed redirect bug when starting program, don't show error page when no errors occur when upload program, little minor improvements
    [app.py]
2025-01-28 fixed show warnings when upload new program
    [app.py]
2025-01-28 refined io-syntax-interpreter, so that short instructions/incomplete instructions like single "R" are handled correctly. Also implemented accept states for the io-syntax
    [turingmachine_interpreter.py]
2025-01-29 fixed some linter issues
    [turingmachine_interpreter.py]
2025-02-04 feat: Add wiringPi and first C++ implementation
2025-02-06 io_band done (w.o. Stepper)
2025-02-12 Workaround: Stepper via Arduino over I2C instead of directly with Raspberry
    [stepper_motor.py, steppermotor_i2p.ino]
2025-02-26 Change from IO2 to UART
2025-02-26 Modify Docker setup and dependencies for UART support
2025-02-26 Arduino stepper UART code
2025-02-27 Add return value and speed mapping to stepper
2025-02-28 Ersetze RPi.GPIO durch libgpiod für Raspberry Pi 5
2025-03-07 improved homing
2025-03-09 fixed cyclic import and bug as int was returned in move_robot()
    [app.py, stepper_motor.py]
2025-03-09 fixed bug where directions not saved as Enum while interpret machine
    [turingmachine_interpreter.py]
2025-03-09 added position tracking to state machine, fixed bug where robot would move right, although it should hold
    [app.py, dannweisstobiesnicht.py, stepper_motor.py]
2025-03-10 Update stepper_motor.py - change SPEED_DELAY_MAP values
2025-03-10 Update assets.py change gpiod pin for light barrier
2025-03-10 moved light barrier in arduino Serial script
2025-03-10 updated homing speed
2025-03-11 outsource sensor processing to Arduino serial
2025-03-11 Update dannweisstobiesnicht.py fix bug
    [dannweisstobiesnicht.py]
2025-03-11 Fix line-too-long in dannweisstobiesnicht.py
    [dannweisstobiesnicht.py]
2025-03-12 changed homing speed
2025-03-12 removed PWA, added Arduino com logging, removed unused assets
2025-03-12 changed default settings and added some debugging prints
